akshit-a9/WayPoint/docs/Reports/Midsem_Report_Akshit_Sharma.docx

# Indoor Localization on ESP32: Mid-Semester Report

Submitted by: Akshit Sharma (2025H1400069G)

## 1. Introduction

By mid-semester, our WiFi-based indoor localization system runs on an ESP32 microcontroller as well as on a phone. It identifies which of 52 locations on two floors of the academic building a device is at, by comparing the signal strengths of nearby WiFi access points with a stored "fingerprint" of each location. We trained four classifiers on 1,247 labelled phone scans; the best, a Random Forest, was correct for 94.1% of test scans and 93.1% of points on a live walk.

## 2. The localization API

We built a small web server (an API) that takes a WiFi scan and returns the predicted location, so the phone app, the ESP32 and a laptop all share the same trained models. The device sends each visible access point's hardware address and signal strength. The server arranges these into the 149-value fingerprint used in training, ignoring unknown access points and filling in missing ones as a very weak signal (−100 dBm). It returns the location name, a confidence score and how many known access points were heard.

Request | What it returns
/health | Whether the server is ready and which models are loaded
/models | The available models and their accuracy
/locations | The names of the 52 locations
/predict | The predicted location for a WiFi scan

All four trained models are loaded at start-up, with the Random Forest as the default. The server is written in Python using FastAPI and has automated tests.

## 3. Running localization on the ESP32

The ESP32 uses the same API: every four seconds it scans for WiFi networks, sends the scan to the server and shows the answer. This needed three changes.

A 2.4 GHz-only model. The ESP32 can only receive 2.4 GHz WiFi, but 73 of the model's 149 access points are 5 GHz. Without them, the original model's accuracy fell from 94.1% to 40.4%. We retrained the Random Forest on the same data with the 5 GHz signals blanked out and added it to the API as a fifth model, without changing the server code.

Model | Networks used | Test accuracy
Original Random Forest | 2.4 and 5 GHz | 94.1%
Original, 5 GHz removed | 2.4 GHz only | 40.4%
Retrained Random Forest | 2.4 GHz only | 91.0%

Firmware, screen and LED. An Arduino program runs the scan, talks to the server and shows the result. A 1.3-inch screen displays the location and confidence, and an RGB LED stays green after a successful prediction and red after an error.

Motion sensor. An MPU6050 accelerometer and gyroscope records 100 readings per second, logged on a laptop together with each WiFi scan on the same clock. This is the data for the navigation stage.

## 4. Challenges and how we overcame them

Challenge | How we solved it
The ESP32 cannot hear 5 GHz networks. | Retrained the model on 2.4 GHz signals only (Section 3).
The screen is damaged and shows only every other line. | The program draws each line twice as thick, so text stays readable.
No resistors were available for the LED. | Set the LED pins to their lowest output current (about 5 mA).
The laptop's address on the phone hotspot changes from time to time. | The board remembers the last working address or searches the network for the server.
A scan takes about 3.7 seconds, so the result colour flashed only briefly. | The result colour now stays on until the next result.

## 5. My contribution

I was responsible for most of the software:

- Built the localization API and its automated tests.
- Found the 5 GHz problem, measured its effect, and added the 2.4 GHz model to the API.
- Wrote the ESP32 firmware: scanning, server communication, screen, LED and automatic server discovery.
- Wrote the hardware test program and the motion-data logging program.

## 6. Status and next steps

The ESP32 gets a prediction from the server in about 0.2 seconds and records motion data at 100 readings per second. Remaining work:

1. Measure the ESP32's accuracy at known locations; the 91.0% figure comes from phone scans.
2. Merge the scans collected with the ESP32 into the training data.
