akshit-a9/WayPoint/(commit log)

2026-10-26 ESP32: rediscover the API when the hotspot hands the laptop a new address
2026-10-26 Move ESP32 firmware out of Indoor-Localization into its own project
    Split from Indoor-Localization-Android (ESP32/) with history. Firmware now
    under firmware/, logger writes to data/sessions/, mid-sem reports in docs/.
2026-10-29 api-server: minimal FastAPI server for the 2.4 GHz model
    localizer.py loads the model and turns a scan into a location; server.py
    exposes /health, /locations and /predict. sample_scan.json is a real test-set
    scan for trying the server without the ESP32.
2026-10-29 firmware: LED module (API LED + RGB status LED)
    API LED is on while the server answers. The RGB LED shows one colour per
    step: purple connecting WiFi, blue scanning, yellow scan sent, green
    response received, red error.
    [leds.cpp, leds.h]
2026-10-29 firmware: display module for the SH1106 OLED
    Two screens: a titled message (boot, errors) and the location result.
    Keeps the row-doubling workaround for our damaged panel behind
    OLED_ROW_DOUBLE.
    [display.cpp, display.h]
2026-10-29 firmware: main sketch: scan -> send -> show, one step at a time
    Connects to WiFi, checks /health once, then loops: scan, POST to
    /predict, show the location. Each step sets the RGB status LED; the API
    LED follows whether the server answered.
2026-10-29 firmware: fix printf format warning in the scanner
    [scanner.cpp]
2026-10-29 README: rewrite for the simplified layout
    Covers the LEDs, wiring, a four-step quick start and the new firmware
    files. Server details live in api-server/README.md.
